yusufemreboyraz/portal-turret-pi/turret/serial_test.py

"""Seri bring-up testi (plan adım 4).

Arduino tek başına çalışıyor mu kontrol eder. config.yaml'daki porttan
elle servo açısı/lazer komutu gönderir.

Kullanım:
  python3 serial_test.py                 # interaktif: "pan tilt eyeX eyeY laser"
  python3 serial_test.py 90 90 90 90 1   # tek komut gönder ve çık
  python3 serial_test.py sweep           # pan'ı min-max süpür (mekanik test)
"""

from __future__ import annotations

import os
import sys
import threading
import time

import yaml

from serial_link import SerialLink

HERE = os.path.dirname(os.path.abspath(__file__))


def main():
    with open(os.path.join(HERE, "config.yaml")) as f:
        cfg = yaml.safe_load(f)
    link = SerialLink(cfg["serial"]["port"], cfg["serial"]["baud"],
                      cfg["serial"]["command_hz"],
                      cfg["serial"]["reconnect_delay_s"])
    s = cfg["servos"]

    args = sys.argv[1:]

    if args and args[0] == "sweep":
        print("pan süpürme; Ctrl+C ile dur")
        lo, hi = s["pan"]["min"], s["pan"]["max"]
        t, c = s["tilt"]["center"], s["eye_x"]["center"]
        try:
            while True:
                for a in list(range(lo, hi, 2)) + list(range(hi, lo, -2)):
                    link.send(a, t, c, s["eye_y"]["center"], True, force=True)
                    time.sleep(0.02)
        except KeyboardInterrupt:
            pass
    elif len(args) == 5:
        link.send(*[int(x) for x in args[:4]], bool(int(args[4])), force=True)
        time.sleep(0.5)
        print("gönderildi:", args)
    else:
        # SÜREKLI mod: girilen değer arka planda ~20Hz tekrar gönderilir,
        # böylece firmware failsafe'i merkeze geri çekmez (kararlı tutar).
        # RAW mod: limitleri kapat (L,0) -> sınır bulurken kelepçe yok,
        # sadece mutlak 0-180 koruması kalır.
        link.send_raw("L,0")
        print("Format: pan tilt eyeX eyeY laser   (boş satır = çık)")
        print(">>> RAW MOD: güvenli kenar limitleri KAPALI (sınır bulma için).")
        print("    Servoyu fiziksel sınıra dayatma; ilk zorlanmada DUR.")
        print("Girilen değer sen yenisini yazana kadar sürekli gönderilir.")
        state = {"cmd": None, "run": True}

        def pump():
            while state["run"]:
                c = state["cmd"]
                if c is not None:
                    link.send(c[0], c[1], c[2], c[3], bool(c[4]), force=True)
                time.sleep(0.05)

        th = threading.Thread(target=pump, daemon=True)
        th.start()
        print("İlk değeri yazınca servo o açıya gider, sen değiştirene "
              "kadar orada tutulur. Makul bir değerle başla, küçük adımlarla git.")
        print("Not: Arduino resetlenirse (USB çıkıp takılırsa) RAW mod sıfırlanır;"
              " serial_test'i yeniden başlat.")
        while True:
            try:
                line = input("> ").strip()
            except EOFError:
                break
            if not line:
                break
            p = line.split()
            if len(p) != 5:
                print("5 değer gerekli (pan tilt eyeX eyeY laser)")
                continue
            try:
                state["cmd"] = [int(p[0]), int(p[1]), int(p[2]),
                                int(p[3]), int(p[4])]
            except ValueError:
                print("hepsi sayı olmalı")
        state["run"] = False
        th.join(timeout=1.0)

    link.close()


if __name__ == "__main__":
    main()
