yusufemreboyraz/portal-turret-pi/(commit log)

2026-05-25 preparing report
    [latency.csv]
2026-05-30 report photos
    [latency_estimate.csv]
